iorodeo/nano_capillary_capsense/README

Design files for multi-channel capillary/capacitence sensor for real-time feeding assay.
