iorodeo/nano_capillary_capsense/base_pcb/images/pdf/basepcb_copper_layers.pdf

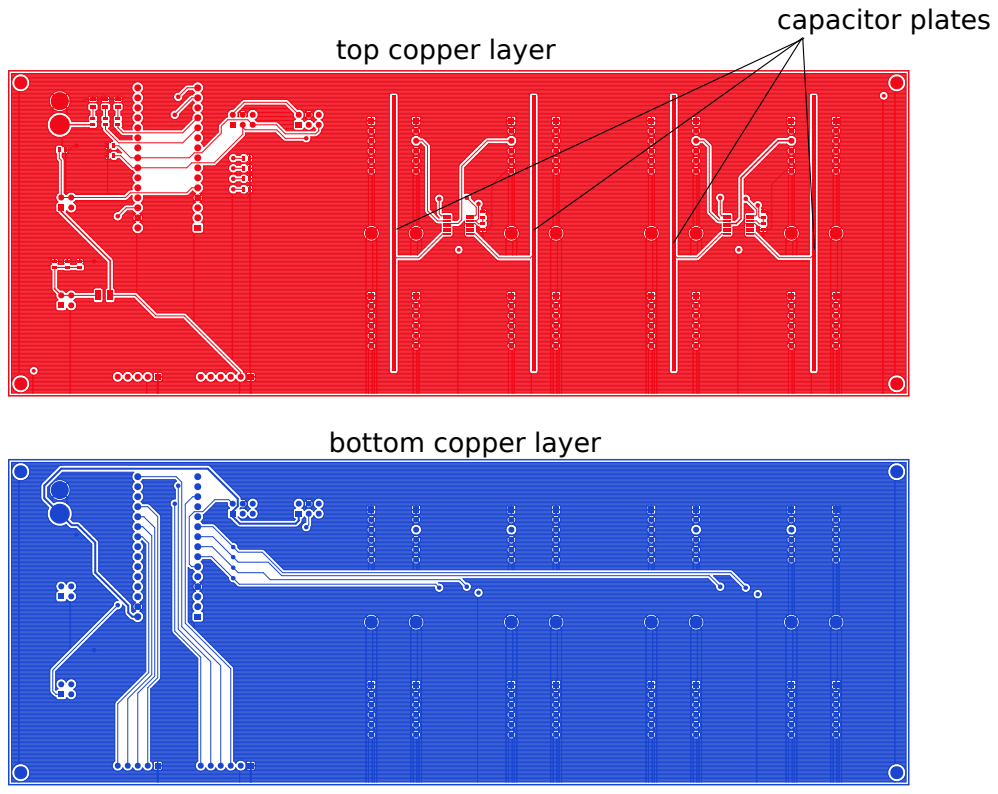
[picture p1: page 1]
capacitor plates

top copper layer

bottom copper layer

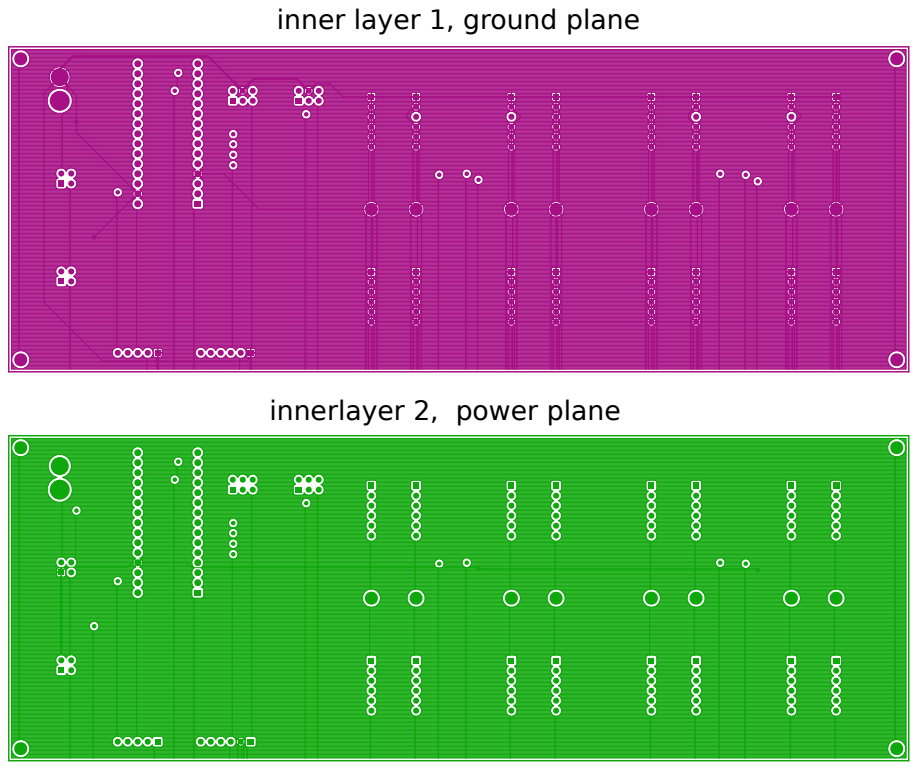
[picture p2: page 2]

inner layer 1, ground plane

innerlayer 2, power plane
