iorodeo/nano_capillary_capsense/base_pcb/images/pdf/basepcb_inner_layers.pdf

inner layer 1, ground plane

innerlayer 2, power plane
