iorodeo/nano_capillary_capsense/base_pcb/images/pdf/basepcb_silkscreen.pdf

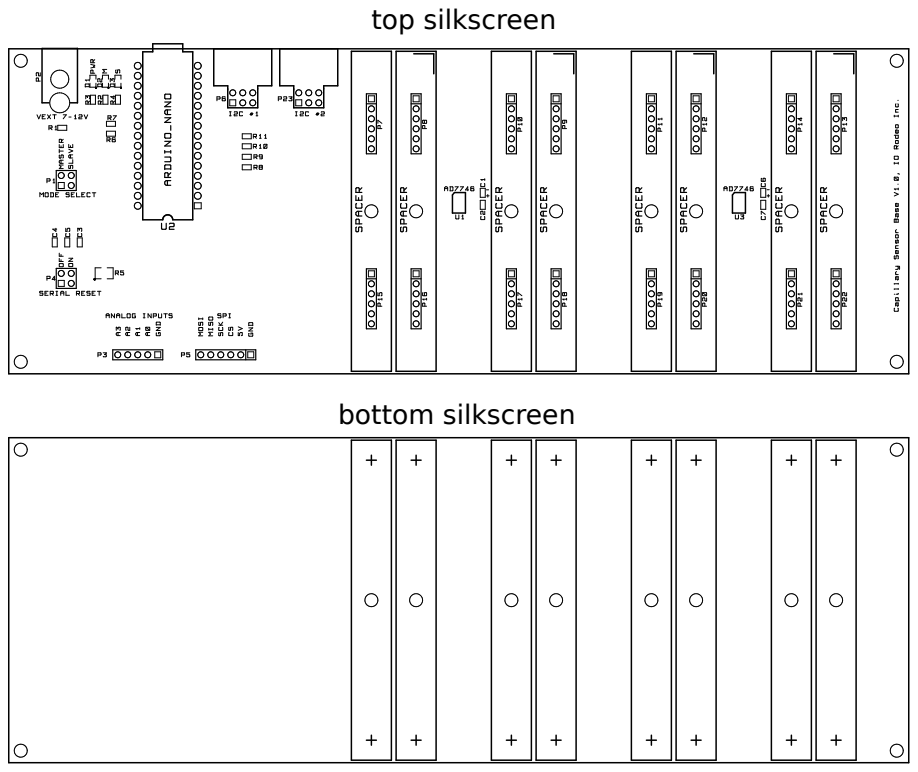
[picture p3: page 1]
top silkscreen; bottom silkscreen
