iorodeo/nano_capillary_capsense/base_pcb/images/pdf/basepcb_top_and_bottom.pdf

capacitor plates

top copper layer

bottom copper layer
