iorodeo/nano_capillary_capsense/spacer_pcb/images/pdf/spacerpcb_layers.pdf

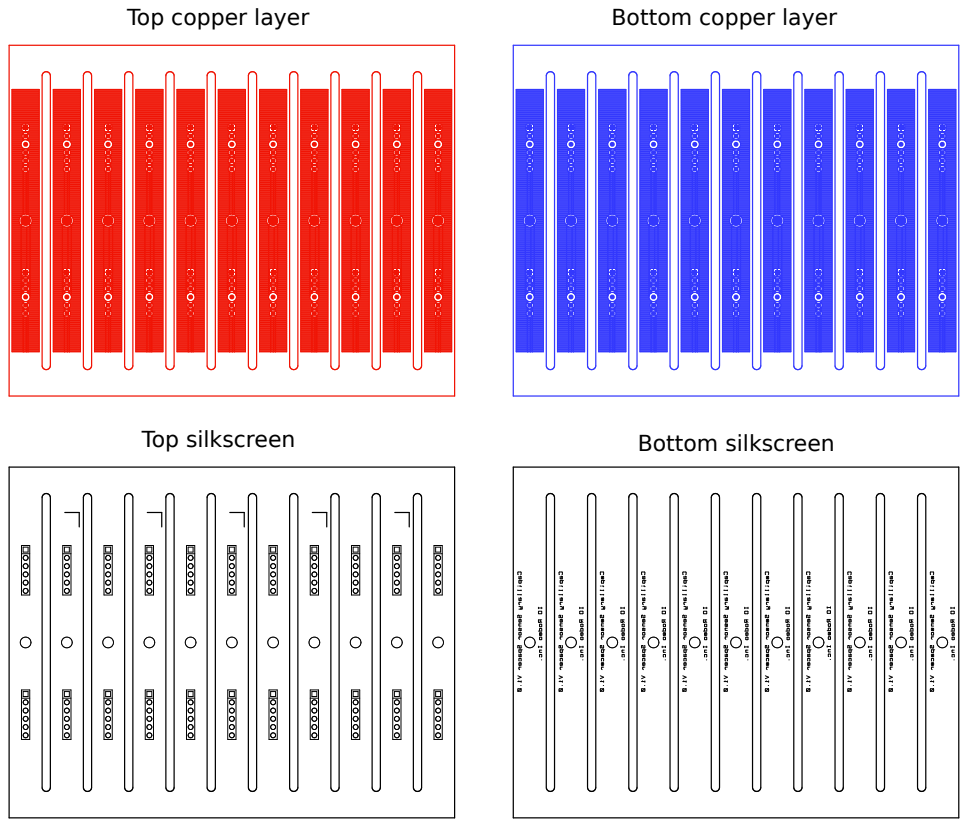
[picture p4: page 1]
Top copper layer; Bottom copper layer; Top silkscreen; Bottom silkscreen
