iorodeo/nano_capillary_capsense/top_pcb/images/pdf/toppcb_layers.pdf

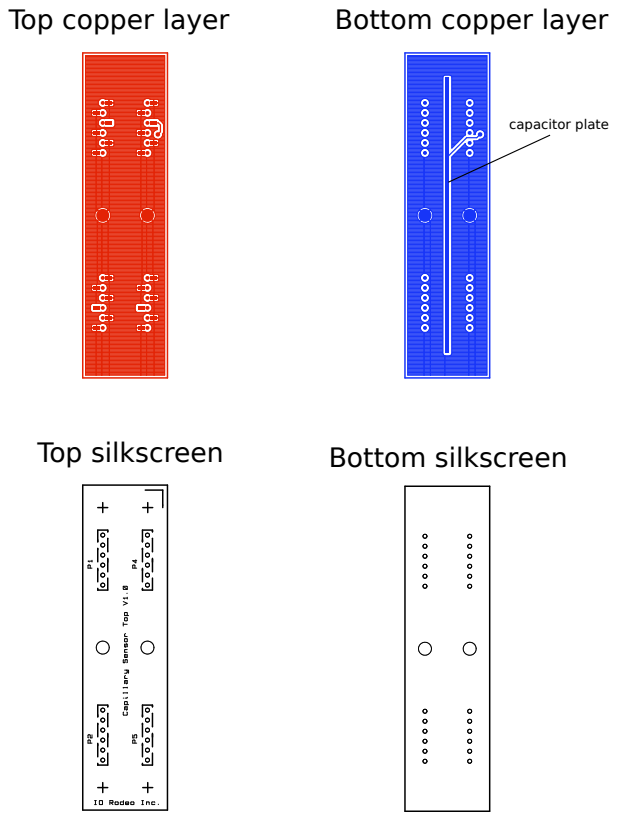
[picture p5: page 1]
Top copper layer; Bottom copper layer; Top silkscreen; Bottom silkscreen; capacitor plate
