iorodeo/nano_capillary_capsense/base_pcb/images/pdf/basepcb_schematic.pdf

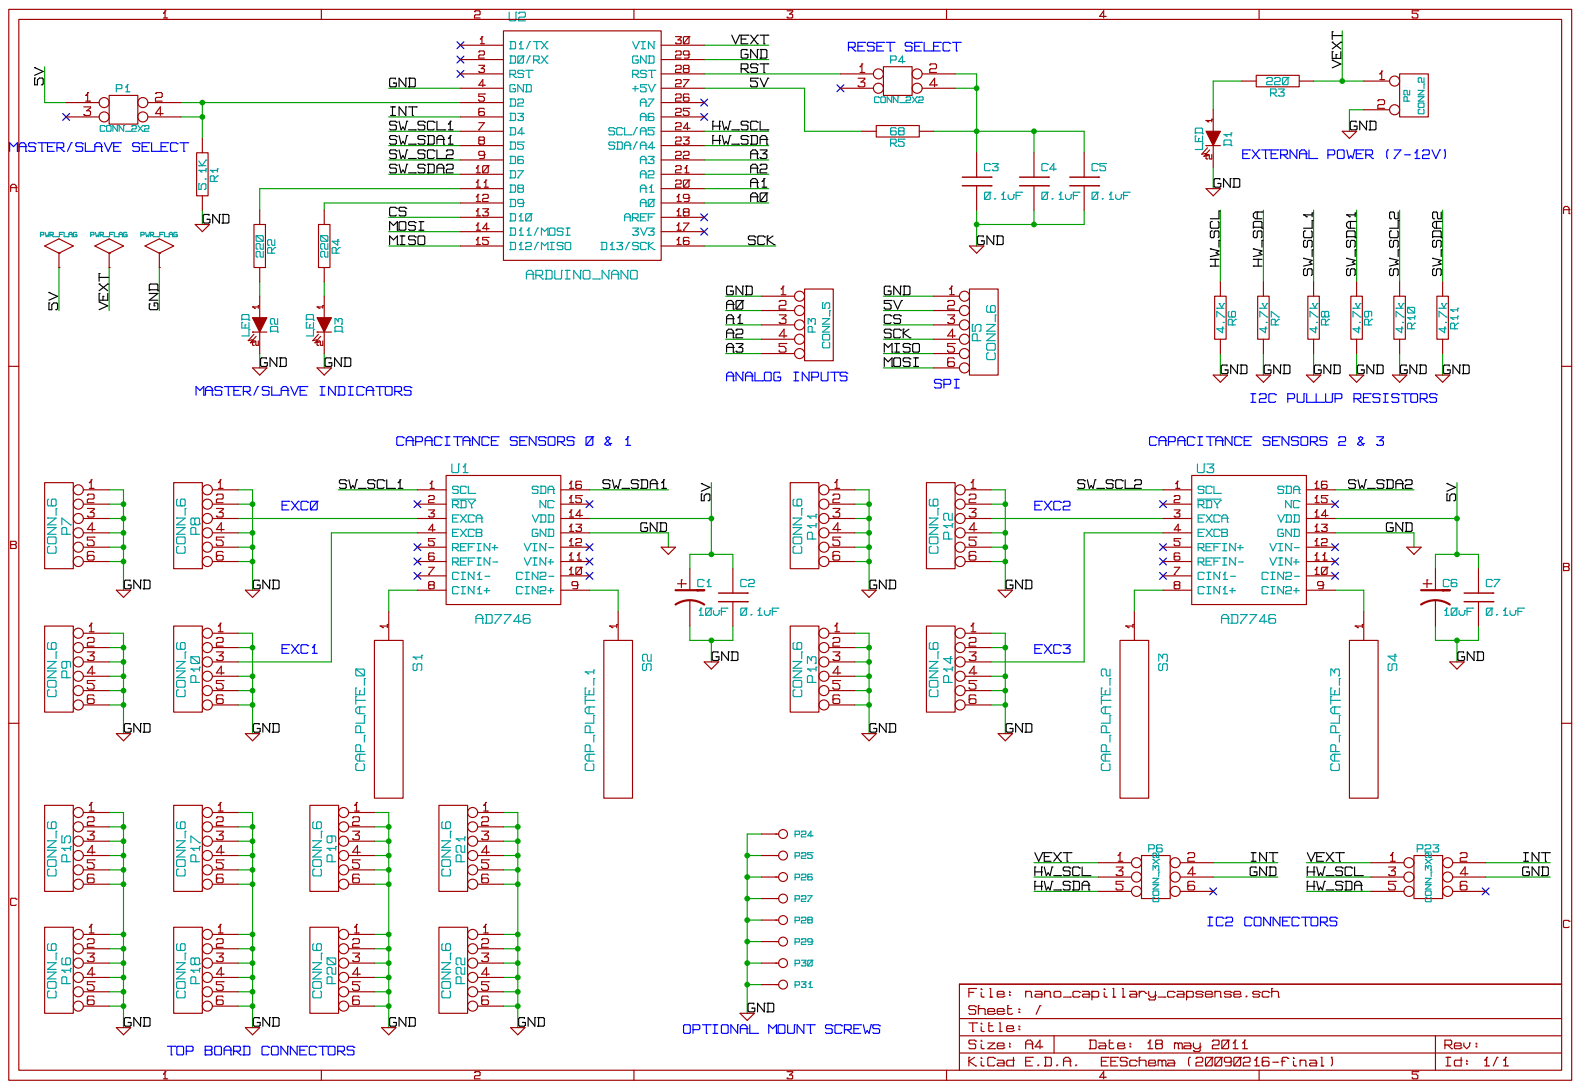
[picture p6: page 1]
