iorodeo/nano_capillary_capsense/spacer_pcb/images/pdf/spacerpcb_schematic.pdf

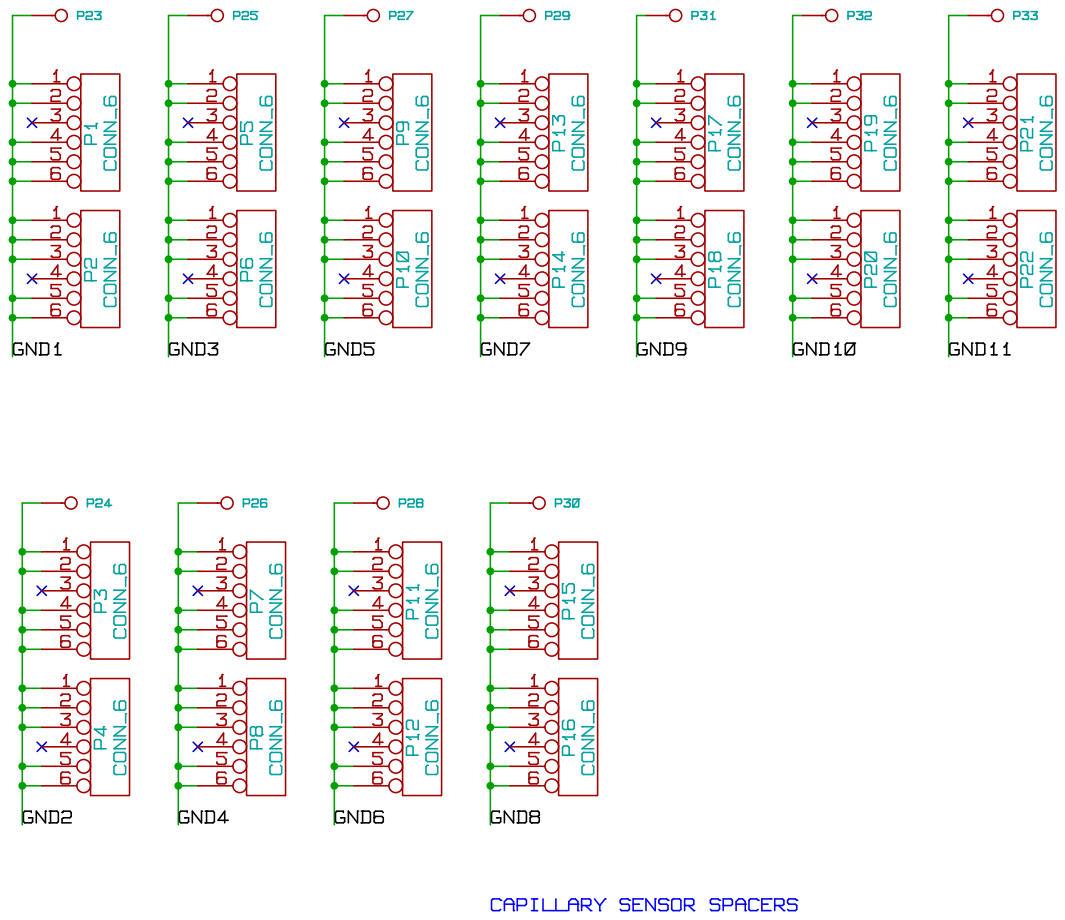
[picture p7: page 1]
