iorodeo/nano_capillary_capsense/top_pcb/images/pdf/toppcb_schematic.pdf

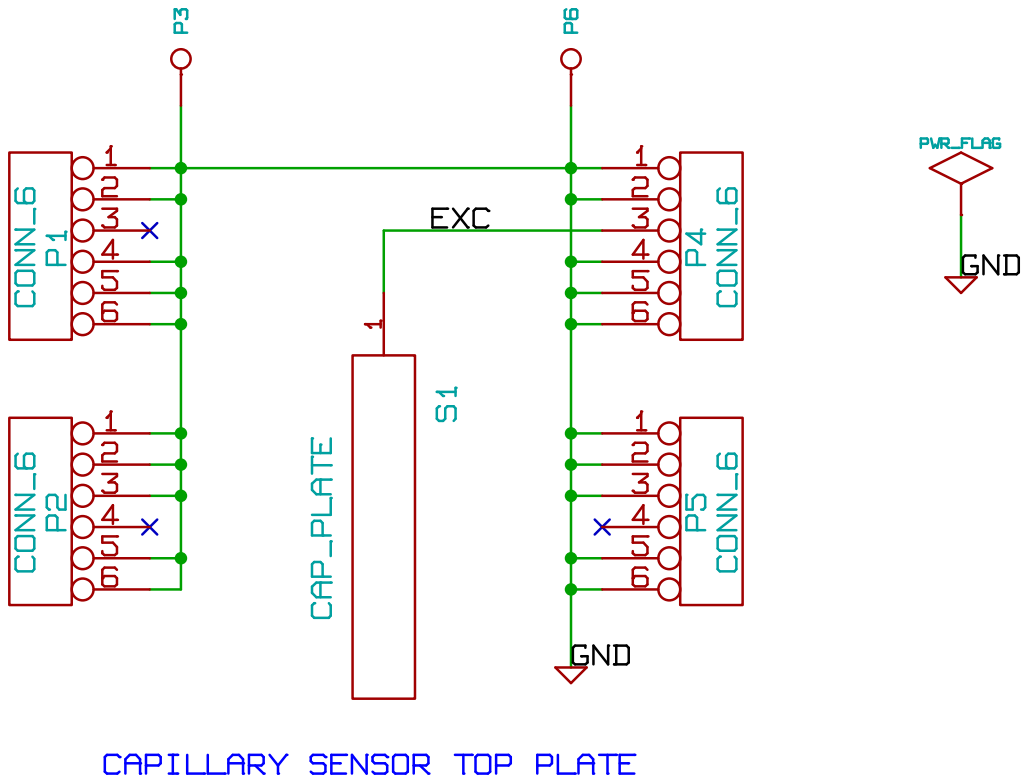
[picture p8: page 1]
