iorodeo/nano_capillary_capsense/base_pcb/images/pdf/basepcb_layout.pdf

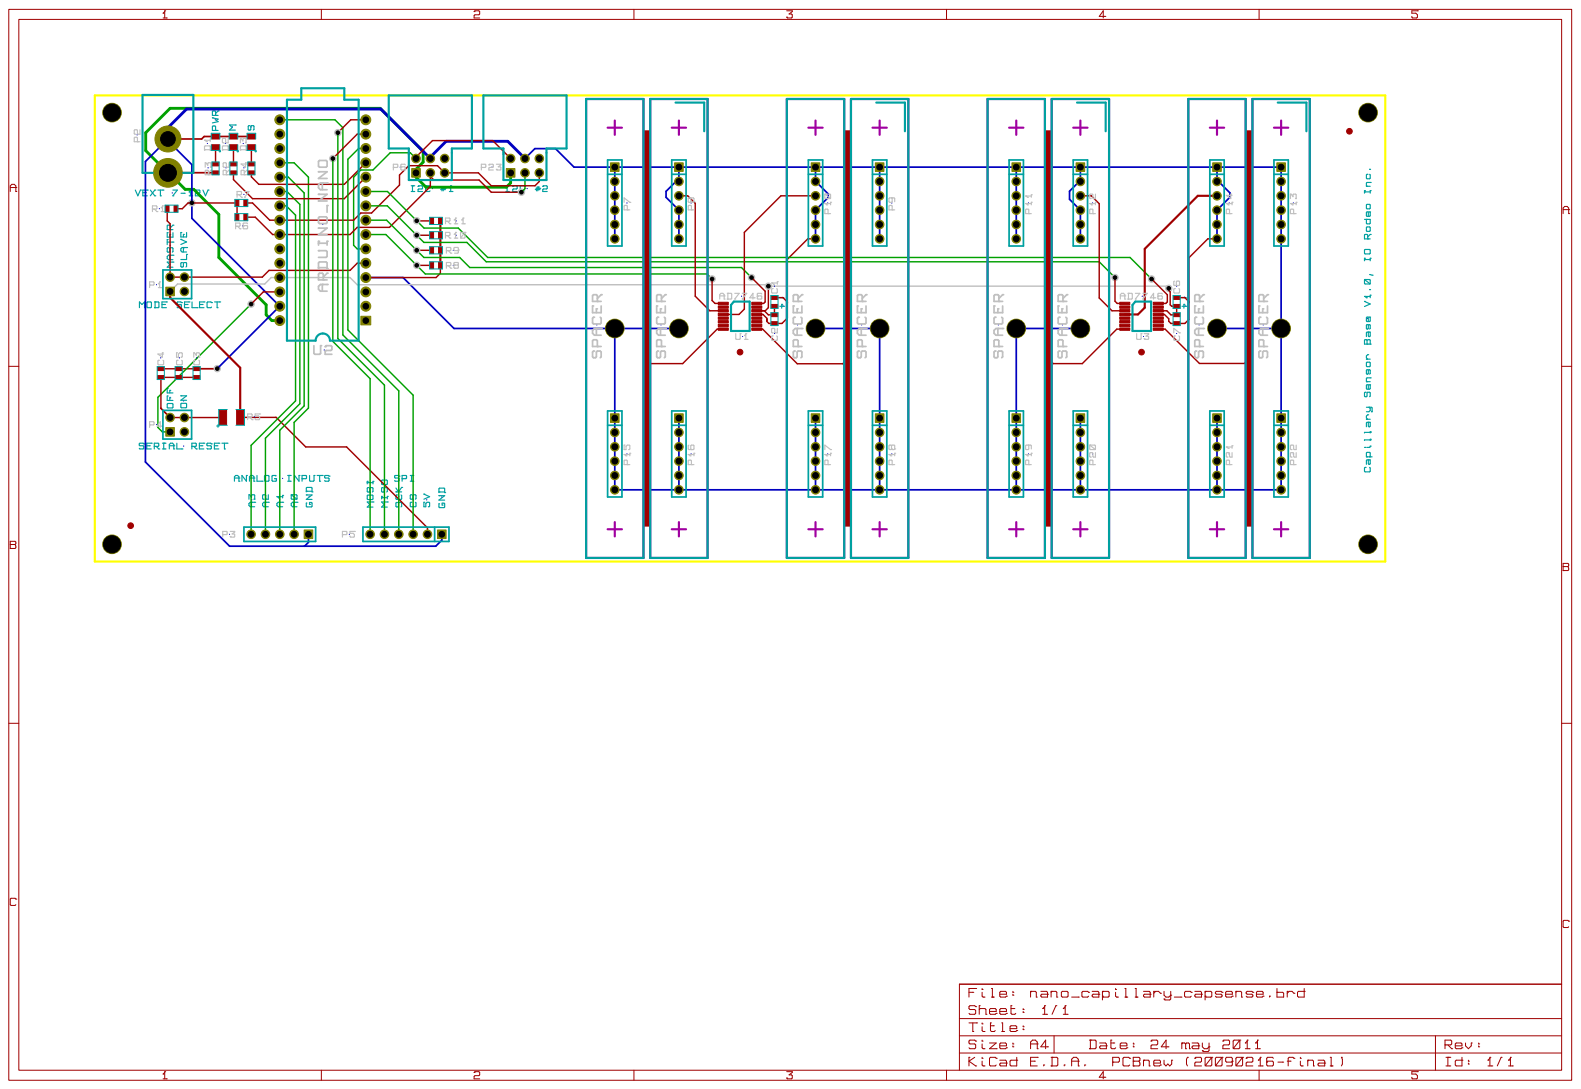
[picture p9: page 1]
