iorodeo/nano_capillary_capsense/spacer_pcb/images/pdf/spacerpcb_layout.pdf

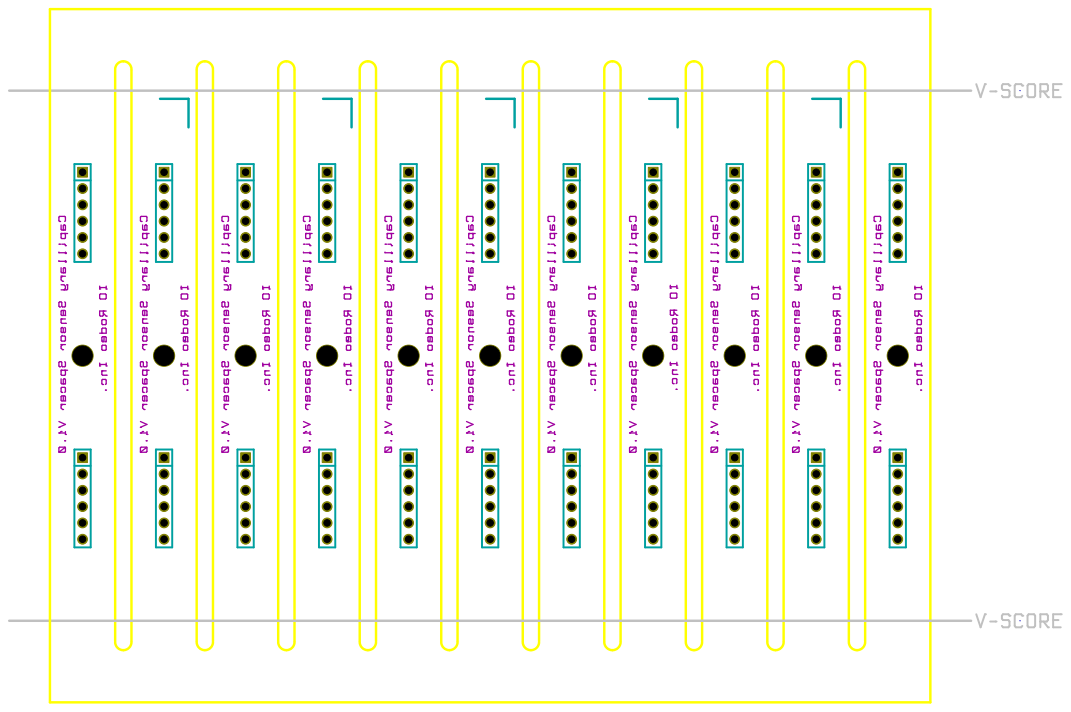
[picture p10: page 1]
