iorodeo/nano_capillary_capsense/top_pcb/images/pdf/toppcb_layout.pdf

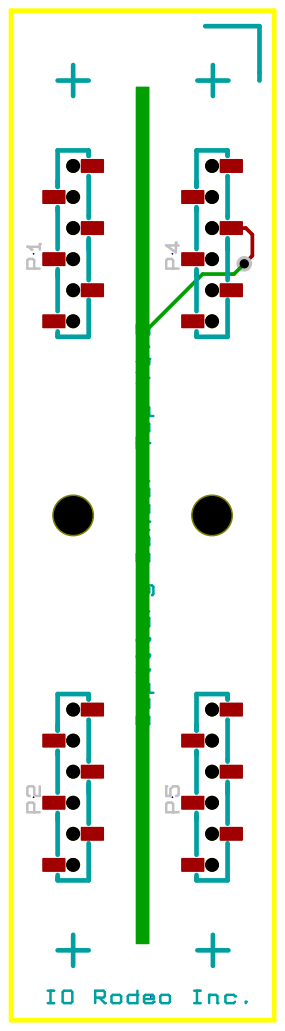
[picture p11: page 1]
