iorodeo/nano_capillary_capsense/base_pcb/nano_capillary_capsense.sch

## KiCad design base_pcb/nano_capillary_capsense.sch (2011-05-24)

Schematic: nano_capillary_capsense.sch

Parts:
C1, C6: 10uF
C2, C3, C4, C5, C7: 0.1uF
D1, D2, D3: LED
P1, P4: CONN_2X2
P2: CONN_2
P3: CONN_5
P5, P7, P8, P9, P10, P11, P12, P13, P14, P15, P16, P17, P18, P19, P20, P21, P22: CONN_6
P6, P23: CONN_3X2
P24, P25, P26, P27, P28, P29, P30, P31: CONN_1
R1: 5.1K
R2, R3, R4: 220
R5: 68
R6, R7, R8, R9, R10, R11: 4.7k
S1: CAP_PLATE_0
S2: CAP_PLATE_1
S3: CAP_PLATE_2
S4: CAP_PLATE_3
U1, U3: AD7746
U2: ARDUINO_NANO

Notes on the sheet:
TOP BOARD CONNECTORS
OPTIONAL MOUNT SCREWS
SPI
EXC3
EXC2
EXC1
EXC0
ANALOG INPUTS
CAPACITANCE SENSORS 2 & 3
CAPACITANCE SENSORS 0 & 1
I2C PULLUP RESISTORS
MASTER/SLAVE INDICATORS
MASTER/SLAVE SELECT
IC2 CONNECTORS
RESET SELECT
EXTERNAL POWER (7-12V)
