iorodeo/nano_capillary_capsense/top_pcb/top.sch

## KiCad design top_pcb/top.sch (2011-05-25)

Schematic: top.sch

Parts:
P1, P2, P4, P5: CONN_6
P3, P6: CONN_1
S1: CAP_PLATE

Notes on the sheet:
CAPILLARY SENSOR TOP PLATE
