iorodeo/nano_capillary_capsense/(commit log)

2011-04-25 Repository creation.
    [nano_capillary_capsense.sch]
2011-04-30 Added CAD models of mounting plates.
    [nano_capillary_capsense.sch]
2011-04-30 Moved license for mount plates to correct directory.
2011-05-18 Finished layingout base_pcb.
    [$savepcb.brd, nano_capillary_capsense.brd, nano_capillary_capsense.sch]
2011-05-18 Added grounded 4-40 through holes for mounting capacitor plates.
    [$savepcb.brd, nano_capillary_capsense.brd, nano_capillary_capsense.sch]
2011-05-19 Finished design of spacer pcbs.
    [$savepcb.brd, nano_capillary_capsense.brd, spacer.brd, spacer.sch]
2011-05-20 Finished top pcb. Fixed some errors in spacer pcb. Still need to add comments to led silkscreen.
    [$savepcb.brd, nano_capillary_capsense.brd, spacer.brd, top.brd, top.sch]
2011-05-21 Made some refinements to the design ... added comments to silkscreen, etc.
    [$savepcb.brd, nano_capillary_capsense.brd, spacer.brd, top.brd]
2011-05-24 Finished intial prototype design. Created some figures illustrating it.
    [$savepcb.brd, nano_capillary_capsense.brd, nano_capillary_capsense.sch, spacer.brd, spacer.sch, top.brd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]
2011-05-25 Moved to 4 layer design for basepcb. Create set of figures illustrating design.
    [$savepcb.brd, nano_capillary_capsense.brd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]
2011-05-25 Finalized design. Created gerber and centroid files.
    [nano_capillary_capsense.brd, spacer.brd, top.brd, top.sch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]
2011-05-27 Some final revisions.
    [$savepcb.brd, nano_capillary_capsense.brd, spacer.brd, top.brd]
